NandanaDoss/Vector_craft/budget_vectorcraft.xlsx

component | specification | units | cost of 1 unit | total cost | PRICE TAKEN FROM
Brushless motors | T Motor Navigator MN4014 330KV | 6 | 8392 | 50352 | India Mart
propellors | 18 inches Carbon fiber | 3 pairs
hexacopter frame | 3D printed
ESC | Hobbywing Xrotor 40 A | 6 | 2000 | 12000
Flight controller | Holybro Pixhawk 6C aluminium case variant | 1 | 35699 | 35699 | robu.in
GPS + IMU | CUAV C-RTK 2HP GNSS Heading Module | 1 | 25887 | 25887 | Indian Robo Store
optical flow sensor | ARK flow MR | 1 | approx 30000 | 30000 | ARK Electronics
telemetry radio | Holybro SiK Telemetry Radio V3-100mW 433 Mhz | 1 | 9446 | 9446 | robu.in
battery pack | GenX Molicel+ 21.6V 13500mAh 6S 3P Premium Pack | 1 | 12900 | 12900 | Robokits India
power module distribution | Holybro PM07 14S Power Management Board | 1 | 5249 | 5249 | robu.in
LIDAR | SLAMTEC RPLIDAR S2 | 1 | 36379 | 36379 | robu.in
Thermal IR camera | Optris CS micro LT | 1 | 27000 | 27000 | Indiamart
payload plate and vibration isolators
landing gear
EMI protection and CAN wiring | Holybro Pixhawk 6C Cable Set | 1 | 2613 | 2613 | holybro store
ON board controller | Raspberry pi 5 model 8GB RAM | 1 | 19999 | 19999 | robu.in
RGB camera | SIYI A8 MINI 4K ULTRA HD 6X Digital zoom gimbal camera | 1 | 26999 | 26999 | Zbiotic
