NandanaDoss/Vector_craft/Frame.step

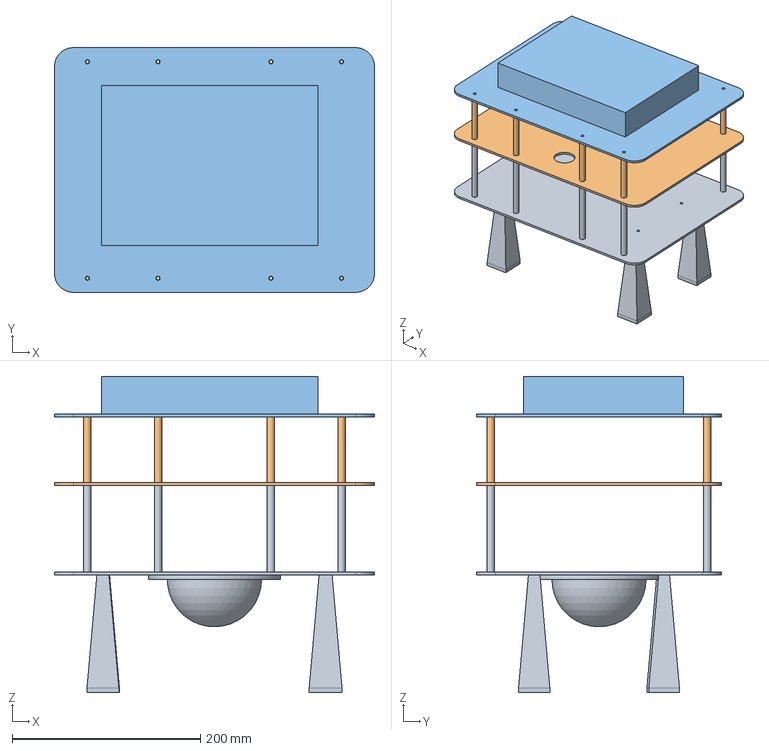
[picture p12: CAD file, 2026-10-11]
Frame.step
340.0 x 260.0 x 336.0 mm
