NandanaDoss/Vector_craft/arms.step

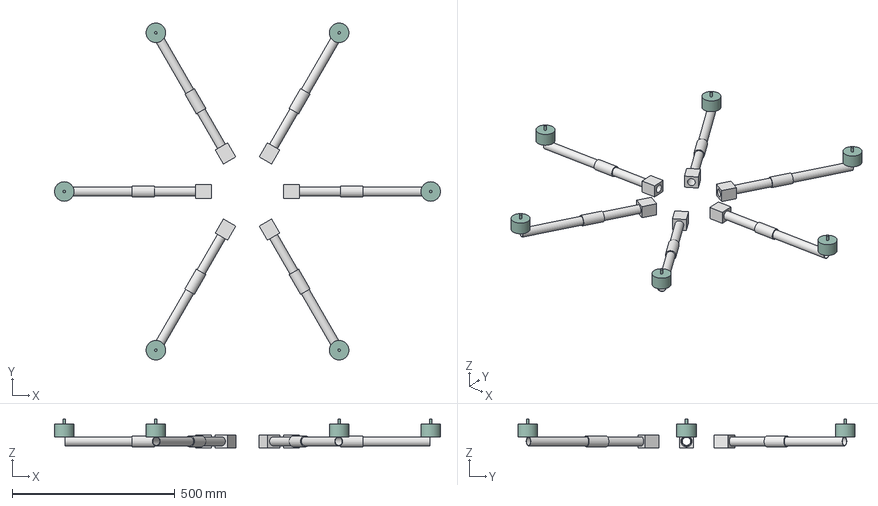
[picture p13: CAD file, 2026-10-11]
arms.step
1184.9 x 1034.3 x 88.0 mm
