NandanaDoss/Vector_craft/Prop_crank_plate.step

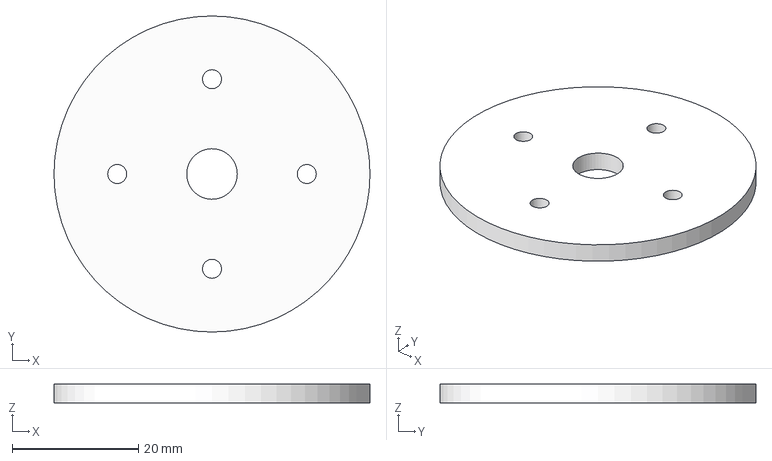
[picture p14: CAD file, 2026-10-11]
Prop_crank_plate.step
50.0 x 50.0 x 3.00 mm
