NandanaDoss/Vector_craft/mirrored properller wing.step

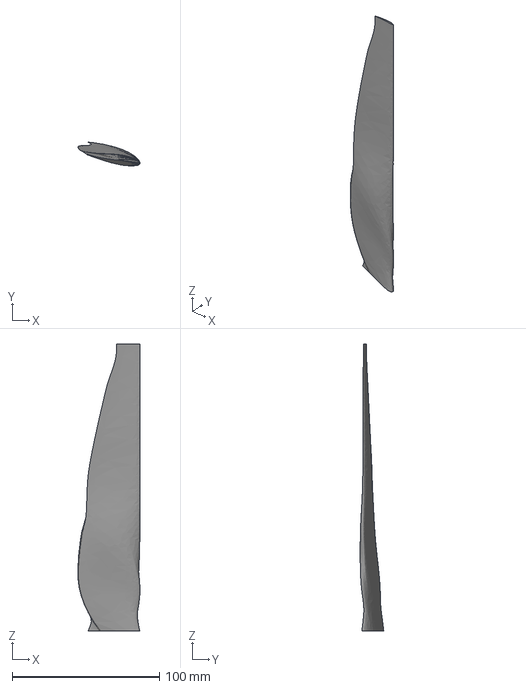
[picture p15: CAD file, 2026-10-11]
mirrored properller wing.step
42.3 x 16.1 x 195.0 mm
