NandanaDoss/Vector_craft/Clockwise Propeller mechanism.step

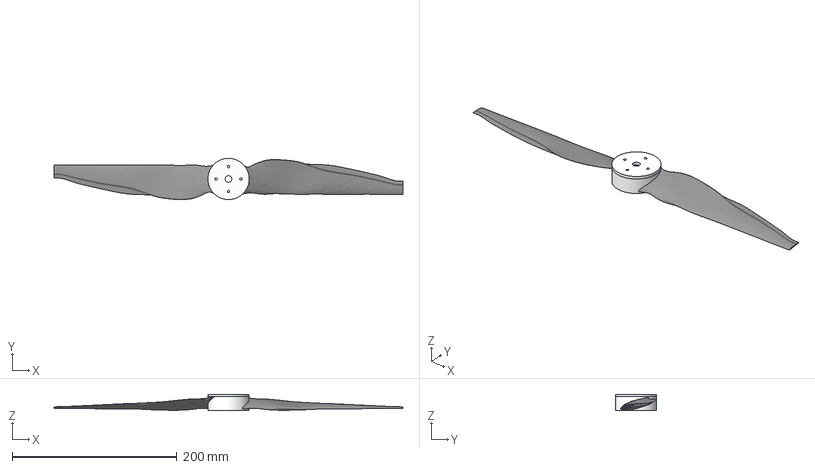
[picture p16: CAD file, 2026-10-11]
Clockwise Propeller mechanism.step
423.3 x 50.0 x 20.0 mm
