NandanaDoss/Vector_craft/HUB Body.step

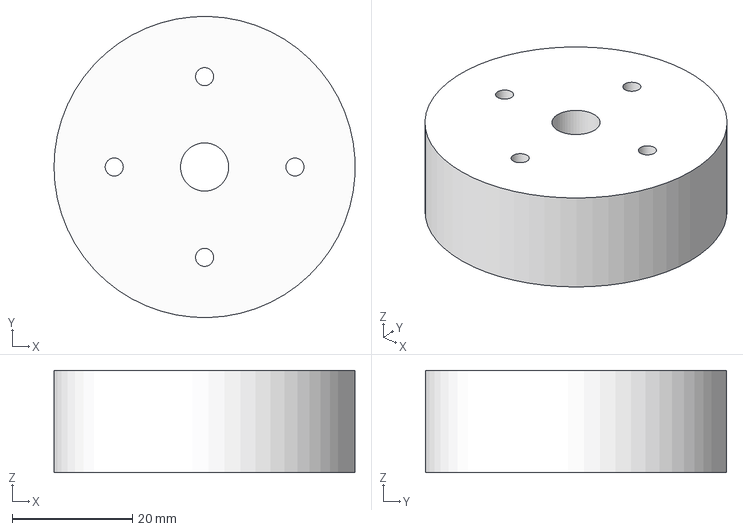
[picture p17: CAD file, 2026-10-11]
HUB Body.step
50.0 x 50.0 x 17.0 mm
