NandanaDoss/Vector_craft/UAV Design.step

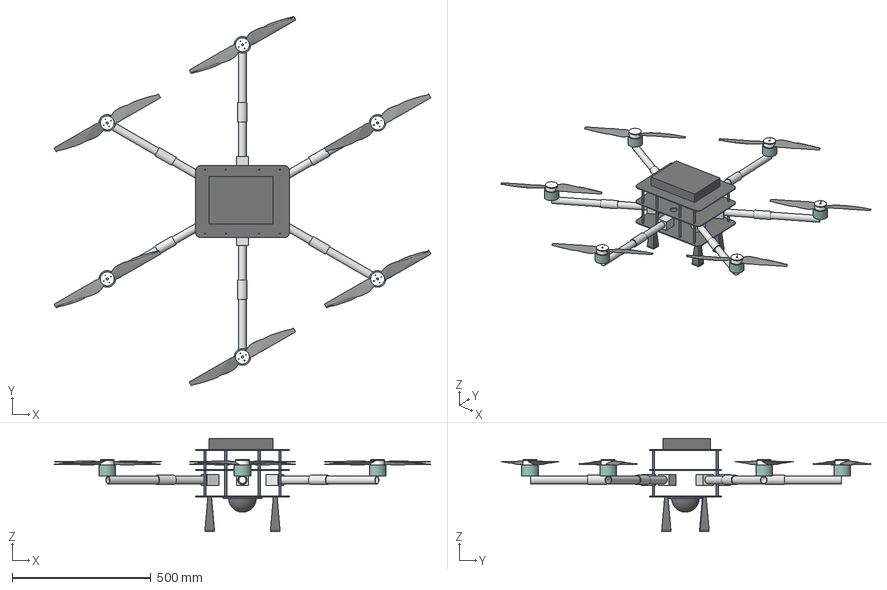
[picture p18: CAD file, 2026-10-11]
UAV Design.step
1358.9 x 1332.7 x 336.0 mm
