NandanaDoss/Vector_craft/Day1/UAV Design.step

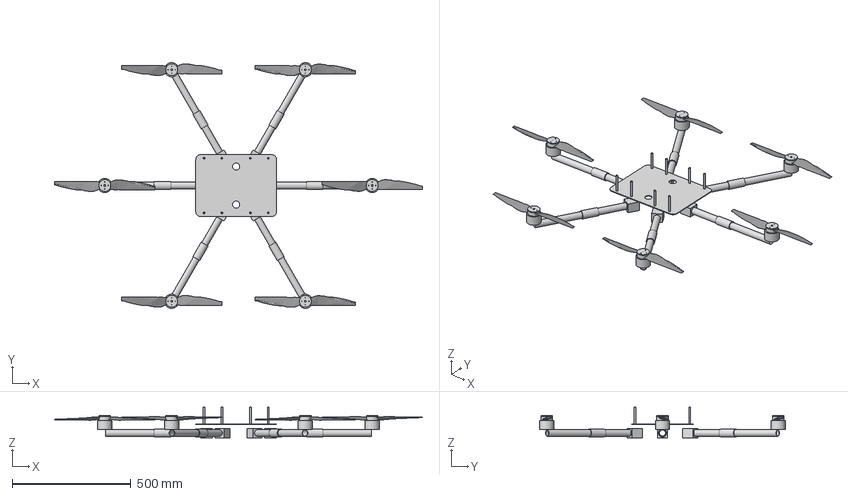
[picture p19: CAD file, 2026-10-10, an earlier design]
Day1/UAV Design.step
1548.3 x 1034.3 x 128.4 mm
