NandanaDoss/Vector_craft/Day1/Frame.step

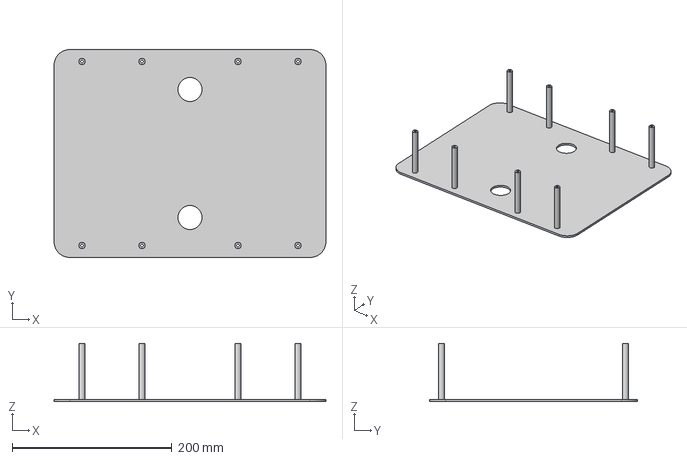
[picture p20: CAD file, 2026-10-10, an earlier design]
Day1/Frame.step
340.0 x 260.0 x 73.0 mm
