NandanaDoss/Vector_craft/(list of files, cad)

Other CAD files:
Propeller Wing.step
anticlockwise propeller mechanism.step
Day1/Clockwise Propeller mechanism.step
Day1/anticlockwise propeller mechanism.step
Day1/HUB Body.step
Day1/Prop_crank_plate.step
Day1/arms.step
